marekpiotrowskimp/family-todo-epaper/marketing/images/linkedin_article_cover_1920x1080.png

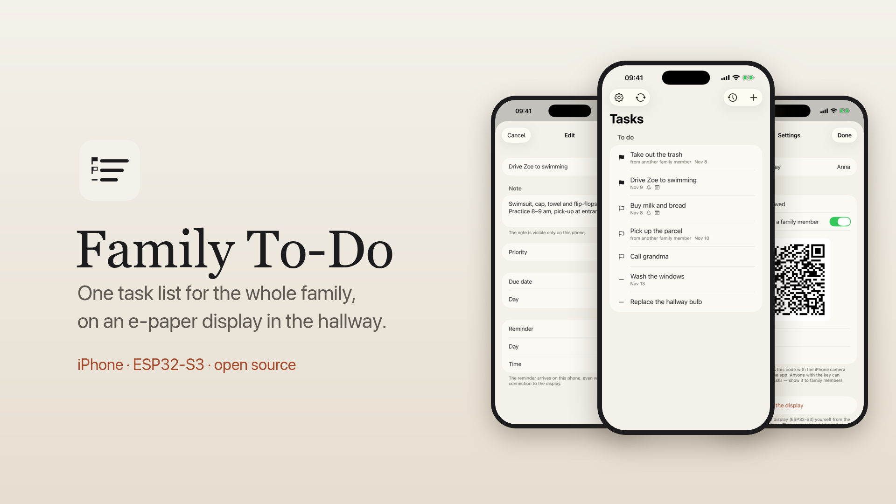
marketing/images/linkedin_article_cover_1920x1080.png
