marekpiotrowskimp/family-todo-epaper/marketing/article/03_settings.png

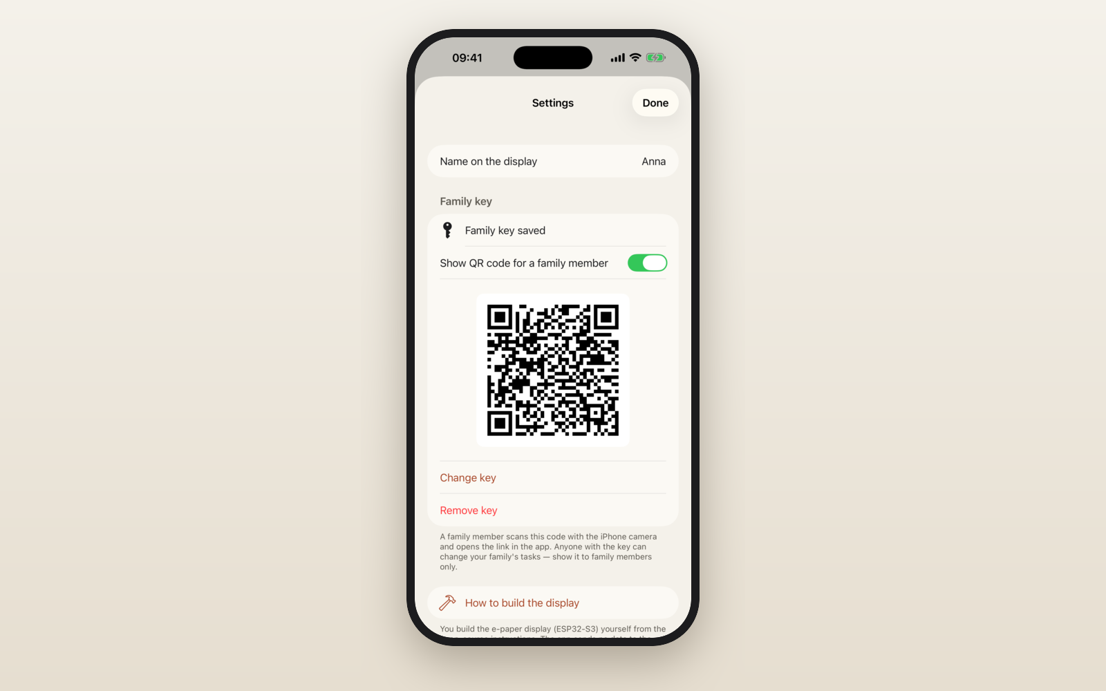
marketing/article/03_settings.png
