marekpiotrowskimp/family-todo-epaper/marketing/article/01_list.png

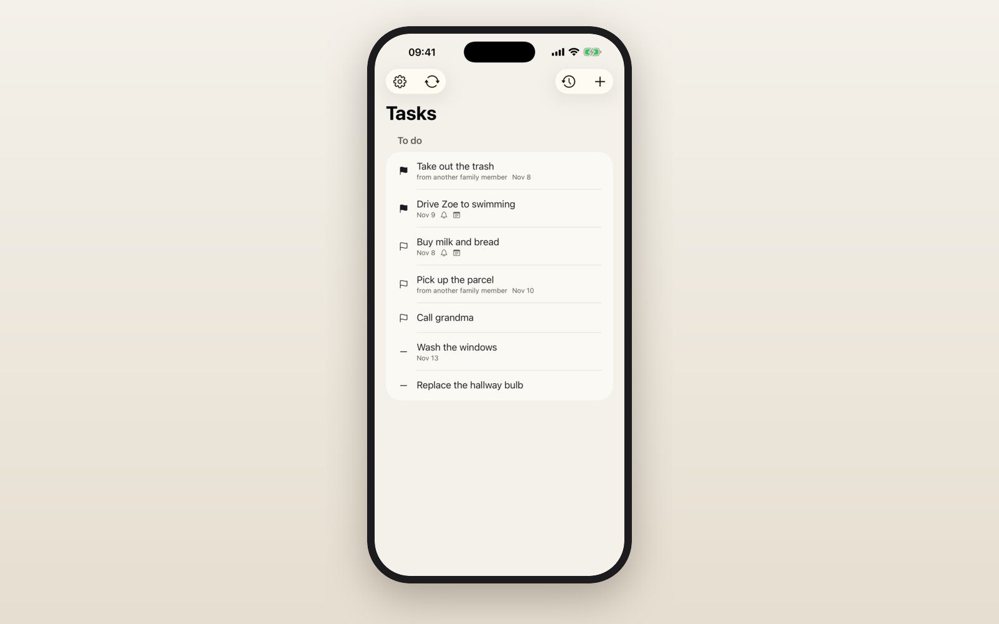
marketing/article/01_list.png
