marekpiotrowskimp/family-todo-epaper/marketing/images/linkedin_post_1080x1350.png

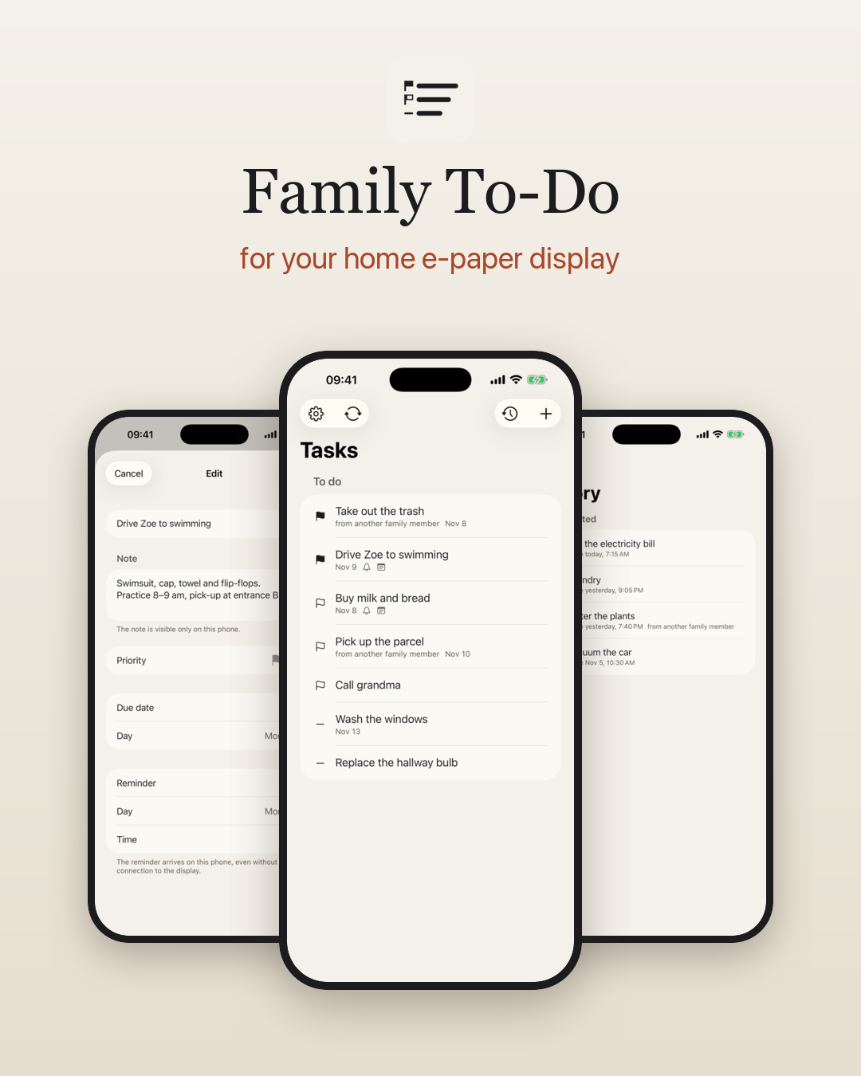
marketing/images/linkedin_post_1080x1350.png
