marekpiotrowskimp/family-todo-epaper/release_apple_store/screenshots/1206x2622/en/01_list.png

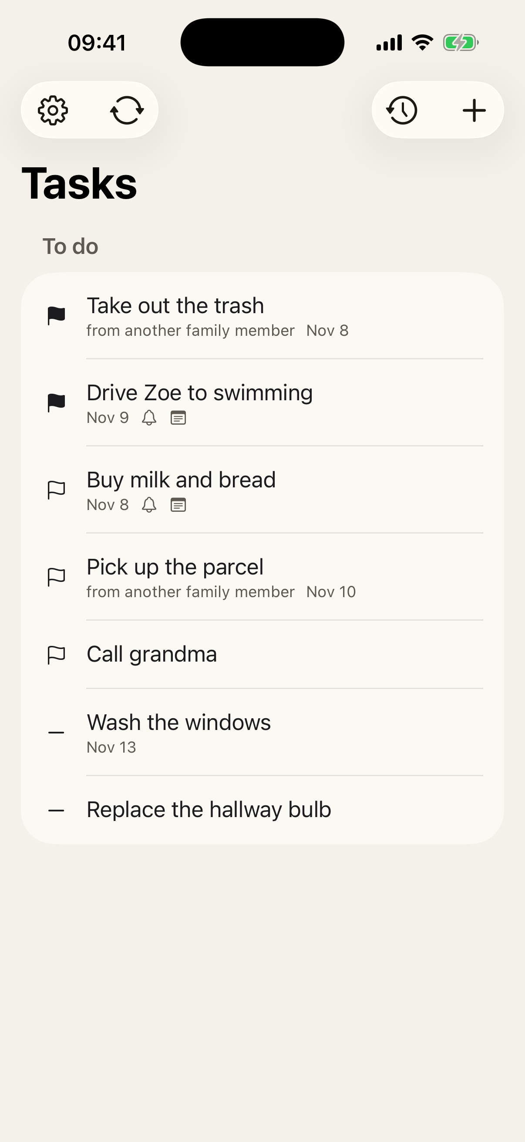
release_apple_store/screenshots/1206x2622/en/01_list.png
