marekpiotrowskimp/family-todo-epaper/release_apple_store/screenshots/1206x2622/pl/01_list.png

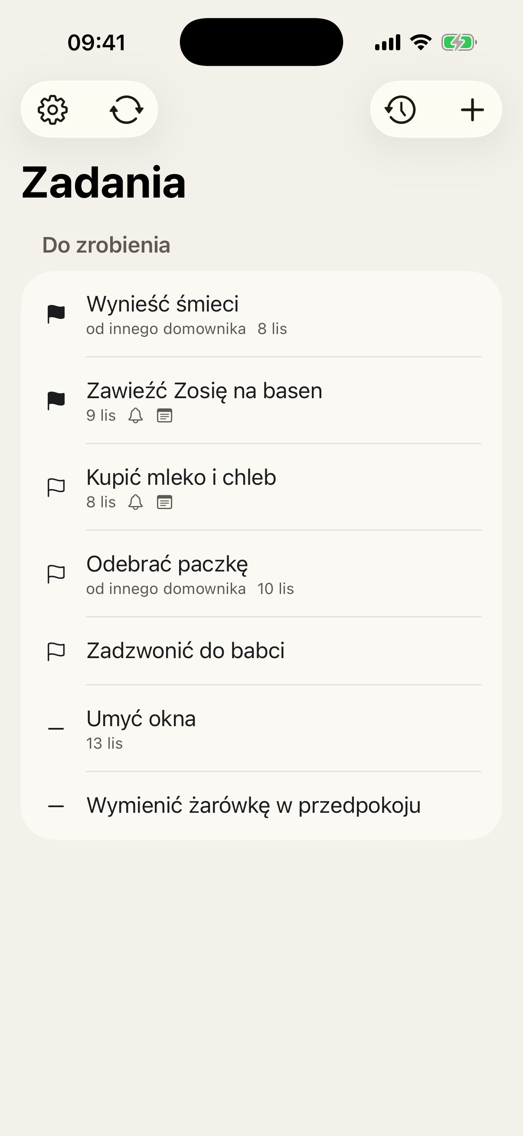
release_apple_store/screenshots/1206x2622/pl/01_list.png
