marekpiotrowskimp/family-todo-epaper/release_apple_store/screenshots/1206x2622/pl/02_editor.png

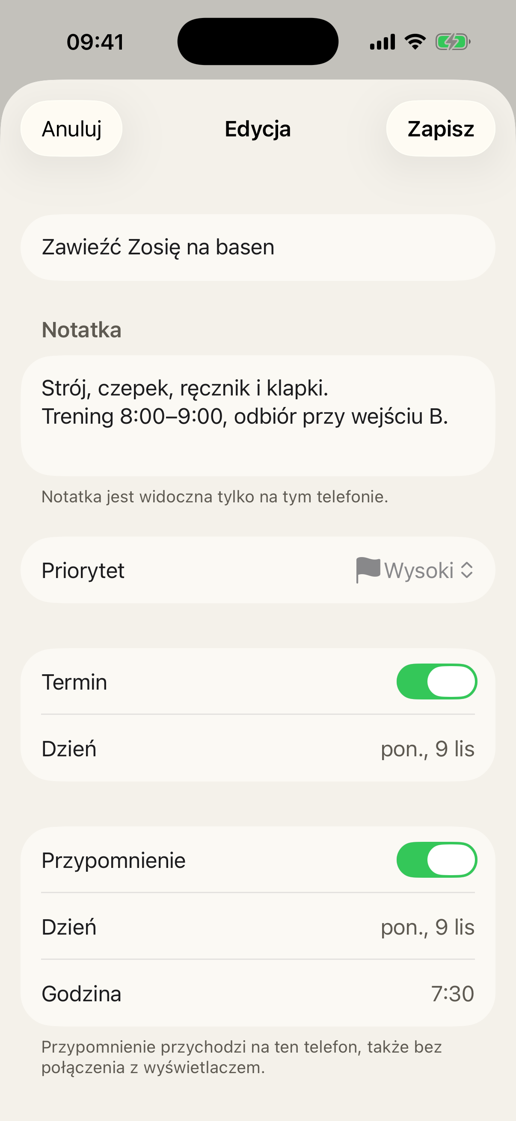
release_apple_store/screenshots/1206x2622/pl/02_editor.png
