marekpiotrowskimp/family-todo-epaper/release_apple_store/screenshots/1320x2868/en/04_settings.png

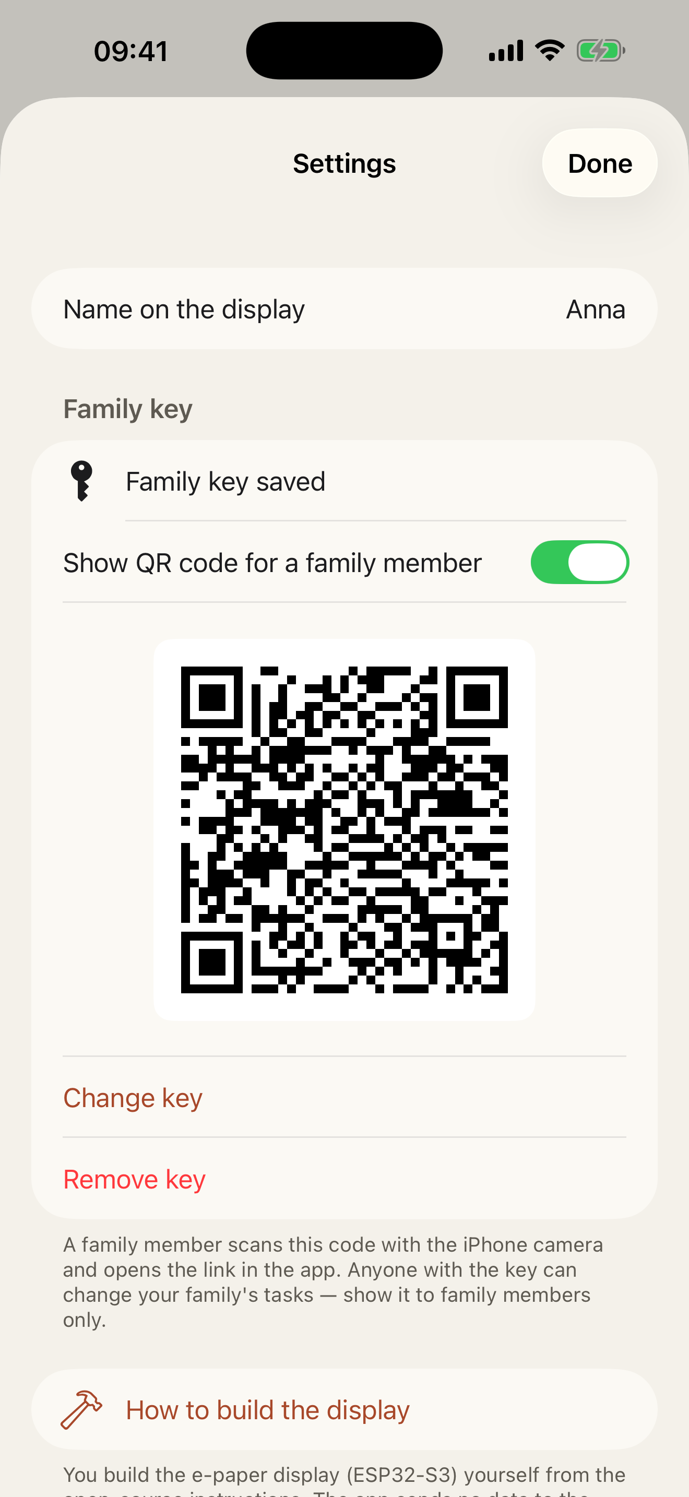
release_apple_store/screenshots/1320x2868/en/04_settings.png
