marekpiotrowskimp/family-todo-epaper/release_apple_store/screenshots/1320x2868/pl/02_editor.png

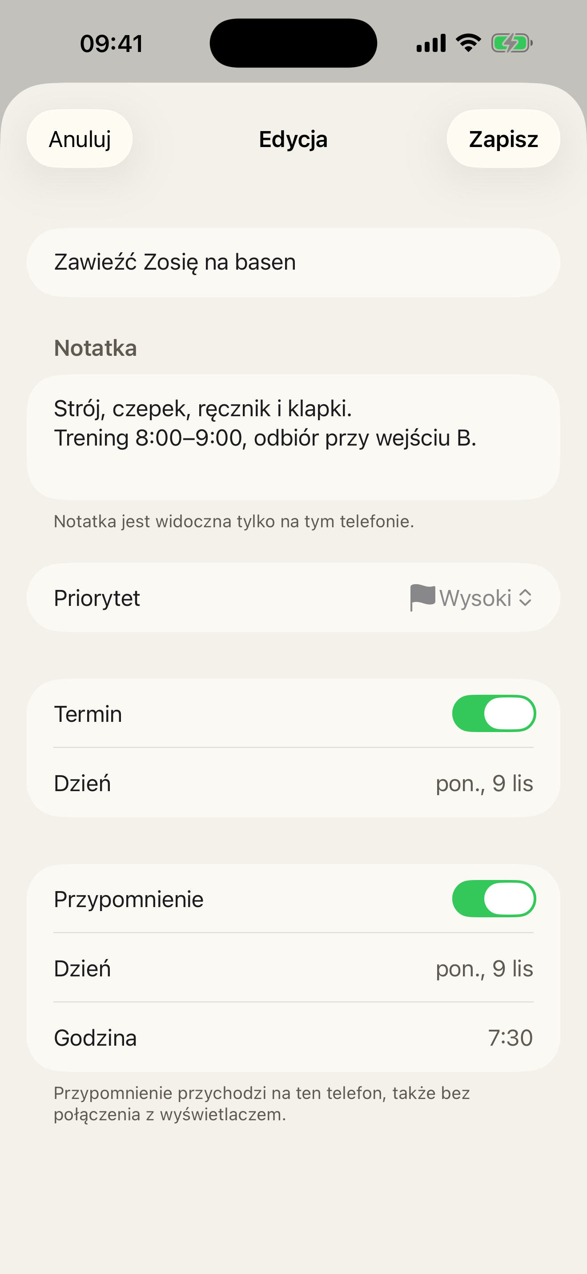
release_apple_store/screenshots/1320x2868/pl/02_editor.png
