marekpiotrowskimp/family-todo-epaper/release_apple_store/screenshots/1320x2868/pl/04_settings.png

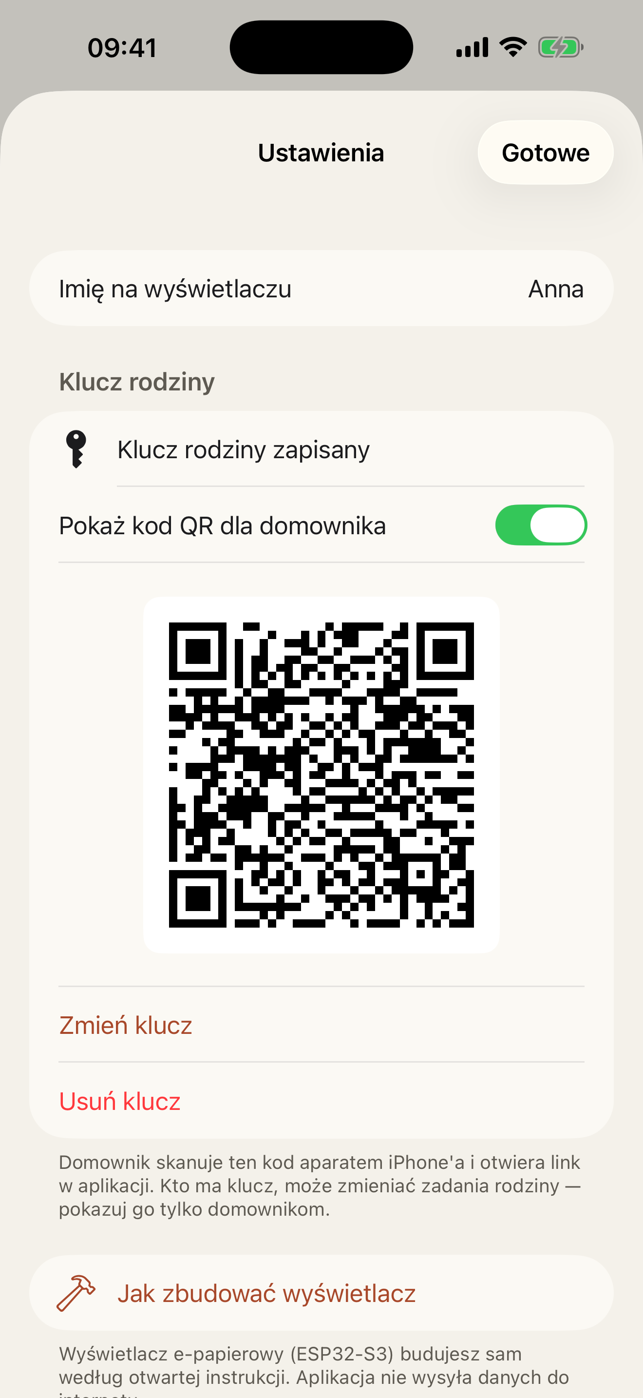
release_apple_store/screenshots/1320x2868/pl/04_settings.png
