marekpiotrowskimp/family-todo-epaper/enclosure/fit_test.stl

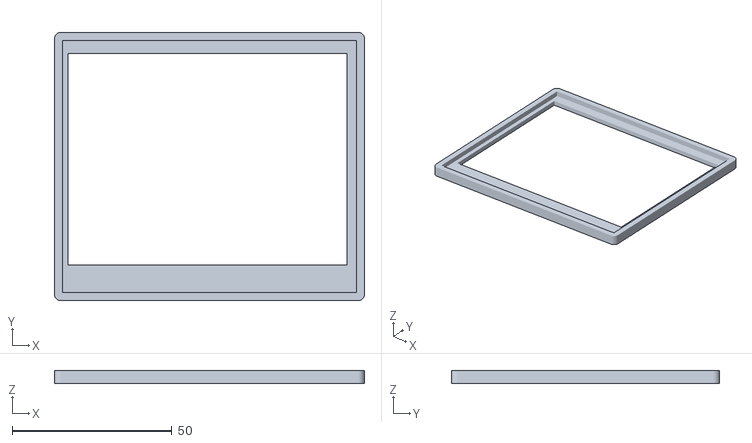
[picture p17: CAD file, 2026-11-03]
enclosure/fit_test.stl
97.0 x 84.0 x 4.20
