marekpiotrowskimp/family-todo-epaper/enclosure/case_body.stl

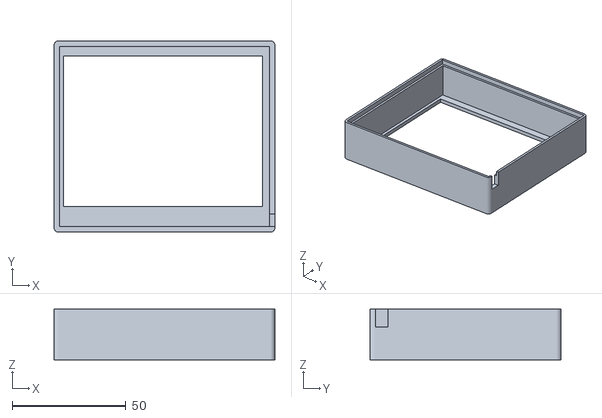
[picture p18: CAD file, 2026-11-03]
enclosure/case_body.stl
97.0 x 84.0 x 22.2
