marekpiotrowskimp/family-todo-epaper/enclosure/case_cover.stl

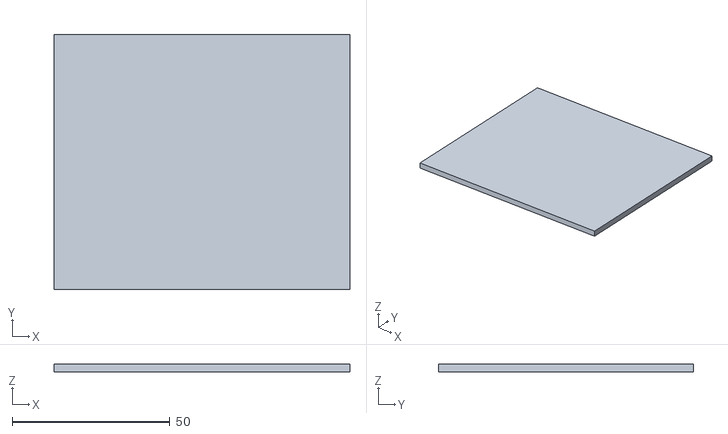
[picture p19: CAD file, 2026-11-03]
enclosure/case_cover.stl
93.9 x 80.9 x 2.50
