marekpiotrowskimp/family-todo-epaper/enclosure/stand.stl

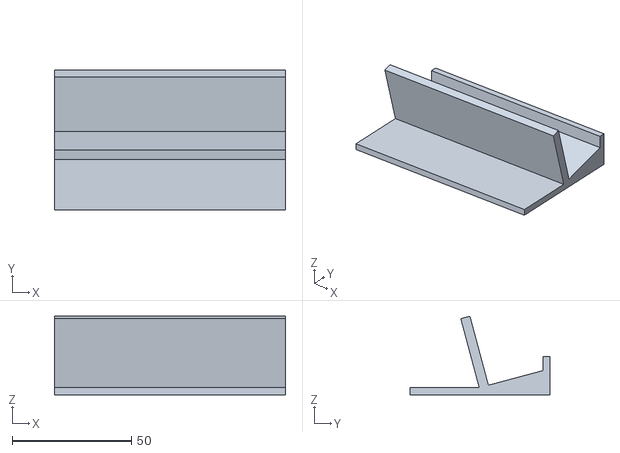
[picture p20: CAD file, 2026-11-03]
enclosure/stand.stl
97.0 x 58.7 x 33.0
