marekpiotrowskimp/family-todo-epaper/release_apple_store/screenshots/1206x2622/pl/05_setup.png

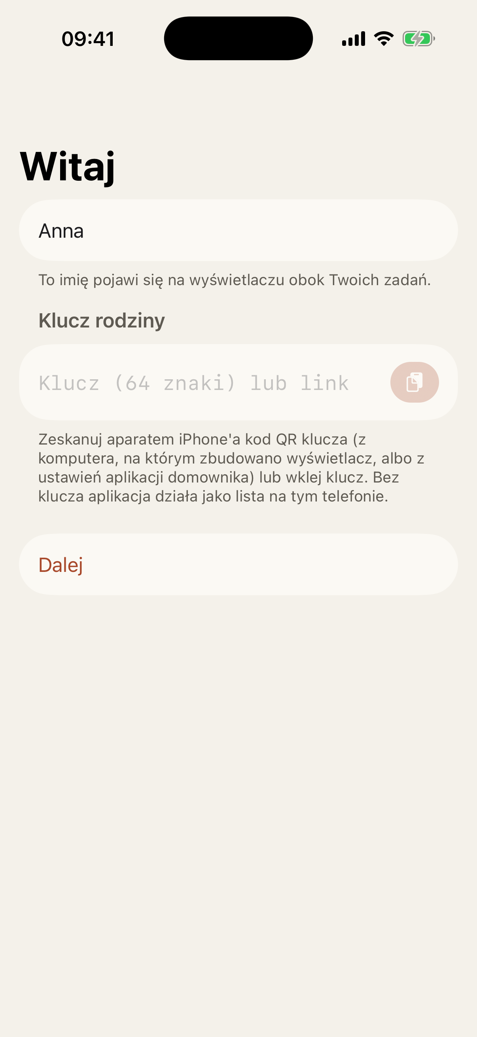
release_apple_store/screenshots/1206x2622/pl/05_setup.png
