marekpiotrowskimp/family-todo-epaper/release_apple_store/screenshots/1320x2868/en/05_setup.png

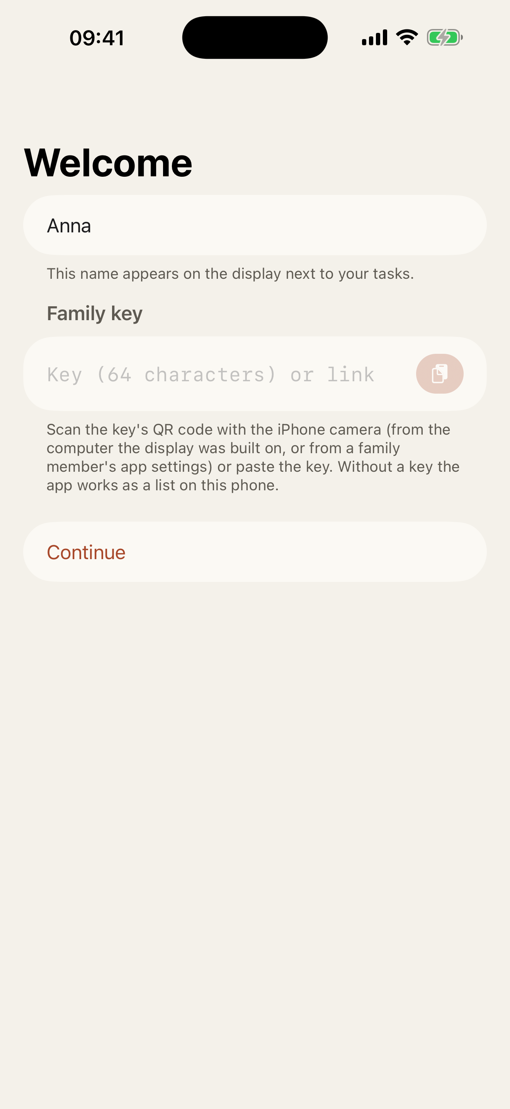
release_apple_store/screenshots/1320x2868/en/05_setup.png
