marekpiotrowskimp/family-todo-epaper/release_apple_store/screenshots/1206x2622/en/03_history.png

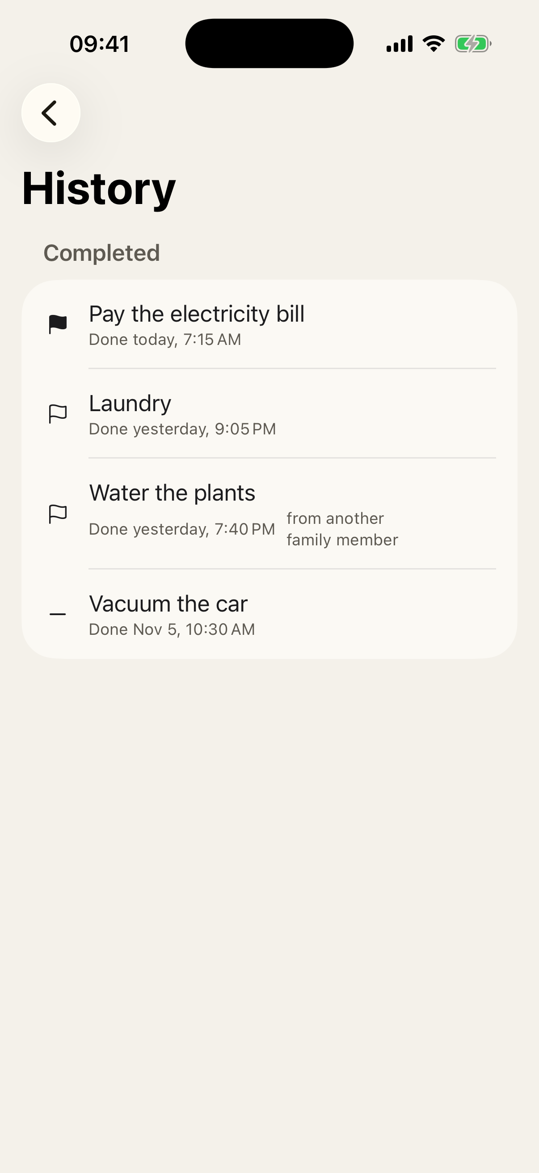
release_apple_store/screenshots/1206x2622/en/03_history.png
