marekpiotrowskimp/family-todo-epaper/(commit log)

2026-11-03 Initial public release
    [case_body.stl, case_cover.stl, epaper_frame.scad, fit_test.stl, stand.stl]
2026-11-05 Sync with upstream: task history, inline date/time editing, centered rows
    - Move completed tasks to a History screen with local completion time
    - Edit task day and time in inline panels instead of popovers
    - Center task rows vertically on the e-paper screen
    - Characterize loading of tasks.json saved by the current app version
    - Ignore SwiftPM build artifacts and vim swap files; drop a tracked .swp file
2026-11-08 iOS: family key entered in the app, English localization, App Store materials
    - The family key is no longer compiled into the app: it is entered on the
    Welcome/Settings screen (paste, familytodo:// link or QR code scanned with
    the Camera app) and kept in the Keychain. Settings can show it as a QR code
    for another family member. tools/make-family-key.sh prints the link/QR.
    - English localization via String Catalogs (Polish stays the source language).
    - iPhone-only target, URL scheme, export compliance and version keys in
    project.yml / Info.plist.
    - release_apple_store/: store texts, privacy policy, support page, demo-data
    screenshot script and screenshots (6.9" and 6.1"/6.3").
    Co-A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
2026-11-08 Release materials: notes in texts, privacy policy and screenshots
    - Demo data has notes, so the editor screenshot shows the Note field and the
    list shows the note icon; all 20 screenshots regenerated.
    - Store description, What's New, privacy policy (notes never leave the phone),
    support FAQ and README mention private notes.
    - make_screenshots.sh waits longer and relaunches the app if it is not running.
2026-11-08 Add App Review notes, review video tooling and LinkedIn materials
    - release_apple_store/REVIEW_NOTES.md: notes for the reviewer with a test key.
    - release_apple_store/review_video/: shot list, YouTube texts and a script
    that assembles the demo video from recorded clips (clips and output ignored).
    - marketing/: LinkedIn article and post with generated graphics.
